techmoocher/kitsujikan/kitsujikan_BOM.csv

Reference | Qty | Part | KiCad footprint | Source | Link | Price (USD) | What It's For
U1 | 1 | Seeed Studio XIAO ESP32-C3 | Imported Parts:XIAO-ESP32-C6-DIP | Amazon | https://www.amazon.com/dp/B0DRNSV5CS | 10.99 | Main microcontroller
U1 (socket) | 2 | 1x7 female header, 2.54 mm | (part of U1 footprint) | DigiKey | https://www.digikey.com/en/products/detail/sullins-connector-solutions/PPTC071LFBN-RC/810146 | 1.16 | Socket for the ESP32-C3 module
J3 (module) | 1 | 0.96 in SSD1306 OLED, 128x64, I2C, 4-pin | Imported Parts:Display_128x64_096_I2C | Amazon | https://www.amazon.com/dp/B0FSRQG23K | 3.33 | Main display module
J3 (socket) | 1 | 1x4 female header, 2.54 mm | Imported Parts:Display_128x64_096_I2C | DigiKey | https://www.digikey.com/en/products/detail/sullins-connector-solutions/PPTC041LFBN-RC/810144 | 0.42 | Socket for the display module
SW2, SW3, SW4, SW5, SW6 | 1 | 12x12x7.3 mm tactile switch + round cap | Button_Switch_THT:SW_PUSH-12mm | Amazon | https://www.amazon.com/dp/B0H271MTGK | 3.99 | Buttons for choosing modes, YES, NO
SW1 | 1 | C&K OS102011MS2QN1 | Button_Switch_THT:SW_Slide_SPDT_Straight_CK_OS102011MS2Q | DigiKey | https://www.digikey.com/en/products/detail/c-k/OS102011MS2QN1/411602 | 0.8 | On/off switch
J1 | 1 | JST PH 2-pin, side entry (S2B-PH-K-S) | Connector_JST:JST_PH_S2B-PH-K_1x02_P2.00mm_Horizontal | DigiKey | https://www.digikey.com/en/products/detail/jst-sales-america-inc/S2B-PH-K-S/926626 | 0.12 | Battery connector
BAT | 1 | 3.7 V LiPo, 500-1000 mAh, protection circuit, JST-PH 2.0 plug | — | Amazon | https://www.amazon.com/dp/B0GHR5J34D?ref=ppx_yo2ov_dt_b_fed_asin_title | 7.49 | Main battery
BZ1 | 1 | Passive magnetic buzzer, 12 mm, 7.6 mm pin spacing, 3 V | Buzzer_Beeper:Buzzer_12x9.5RM7.6 | DigiKey | https://www.digikey.com/en/products/detail/same-sky-formerly-cui-devices/CEM-1203-42/412412 | 1.04 | Buzzer for sound output
Q1 | 1 | 2N3904 NPN transistor, TO-92 | Package_TO_SOT_THT:TO-92_Inline | DigiKey | https://www.digikey.com/en/products/detail/onsemi/2N3904BU/1413 | 0.29 | Transistor for driving the buzzer
R1, R2 | 2 | 200 kΩ, 1/4 W | Resistor_THT:R_Axial_DIN0207_L6.3mm_D2.5mm_P10.16mm_Horizontal | DigiKey | https://www.digikey.com/en/products/detail/stackpole-electronics-inc/CF14JT200K/1741338 | 0.027 | Pull-up resistors for I2C lines
R3, R5 | 2 | 10 kΩ, 1/4 W | Resistor_THT:R_Axial_DIN0207_L6.3mm_D2.5mm_P10.16mm_Horizontal | DigiKey | https://www.digikey.com/en/products/detail/stackpole-electronics-inc/CF14JT10K0/1741265 | 0.027 | Pull-down resistors for buttons
R4 | 1 | 1 kΩ, 1/4 W | Resistor_THT:R_Axial_DIN0207_L6.3mm_D2.5mm_P10.16mm_Horizontal | DigiKey | https://www.digikey.com/en/products/detail/stackpole-electronics-inc/CF14JT1K00/1741314 | 0.027 | Current-limiting resistor for the buzzer
C1 | 1 | 100 nF ceramic capacitor (104) | Capacitor_THT:C_Disc_D5.0mm_W2.5mm_P5.00mm | DigiKey | https://www.digikey.com/en/products/detail/onsemi/1N4148/458603 | 0.1 | Decoupling capacitor for the ESP32-C3
PCB | 5 | 2-layer PCB, 65 x 90 mm, 1.6 mm, HASL | — | JLCPCB | https://jlcpcb.com | 0.80 | Printed circuit board for the project
