techmoocher/kitsujikan/kitsujikan_schematic.pdf

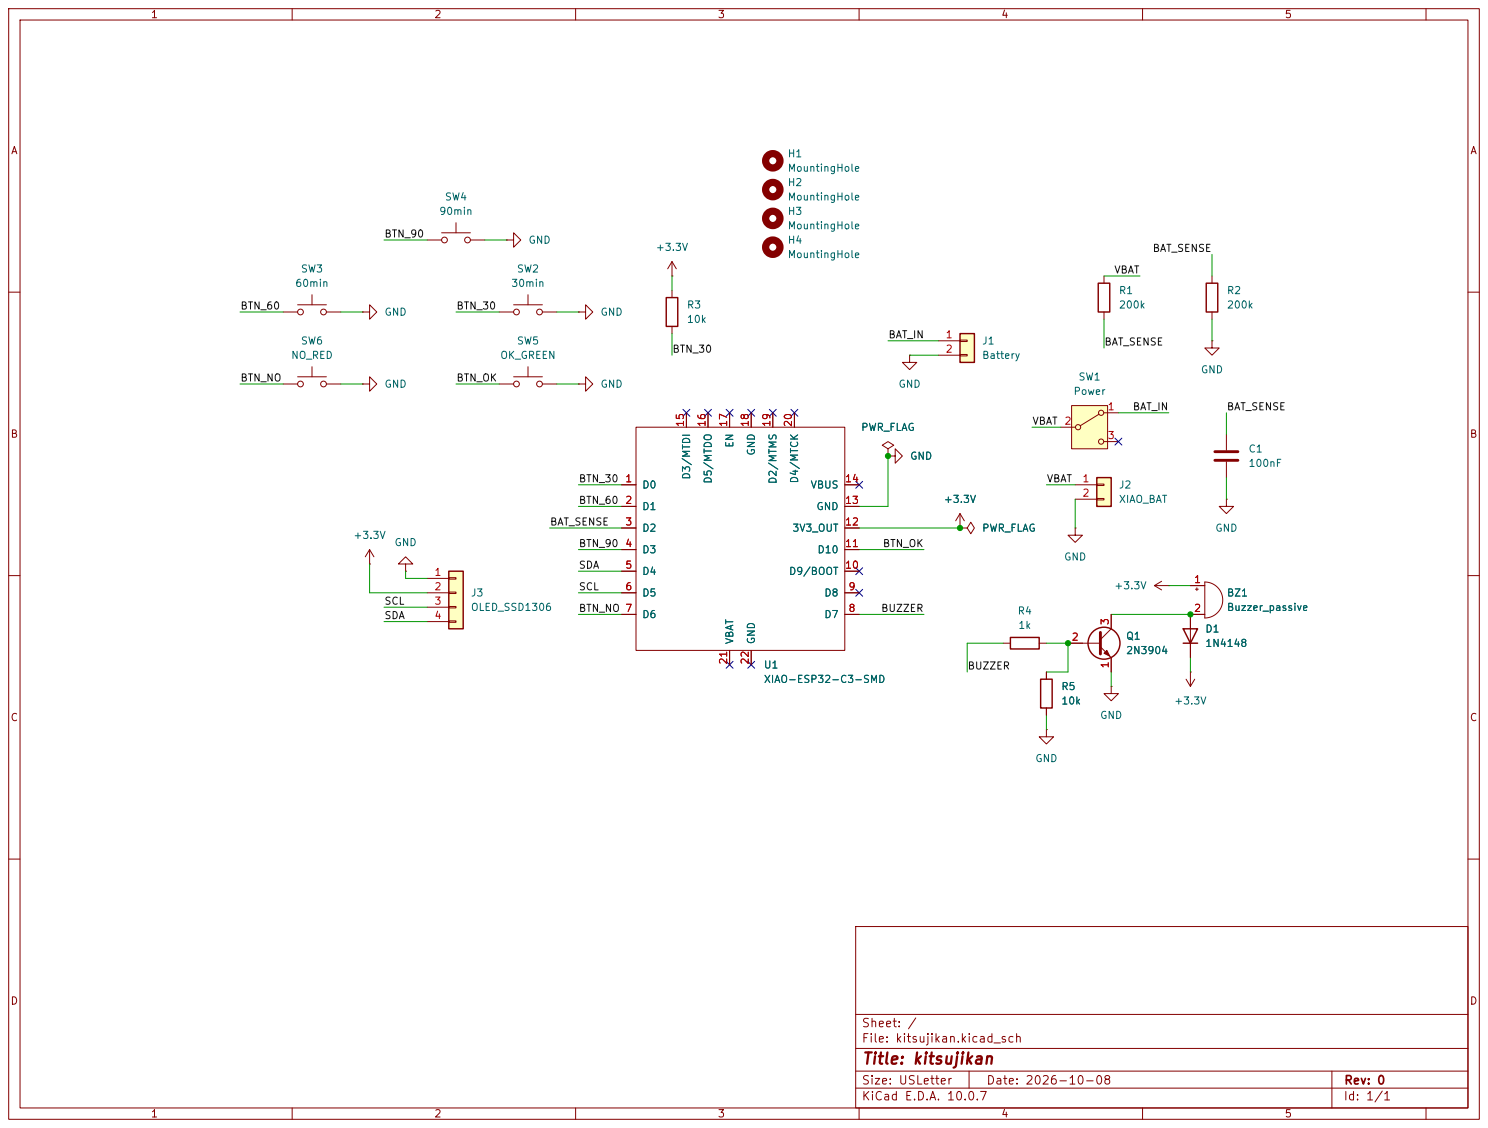
[picture p10: page 1]

Size: USLetter | Rev: 0
KiCad E.D.A. 10.0.7 | Id: 1/1
