techmoocher/kitsujikan/PCB/production/pdf/kitsujikan-B_Cu.pdf

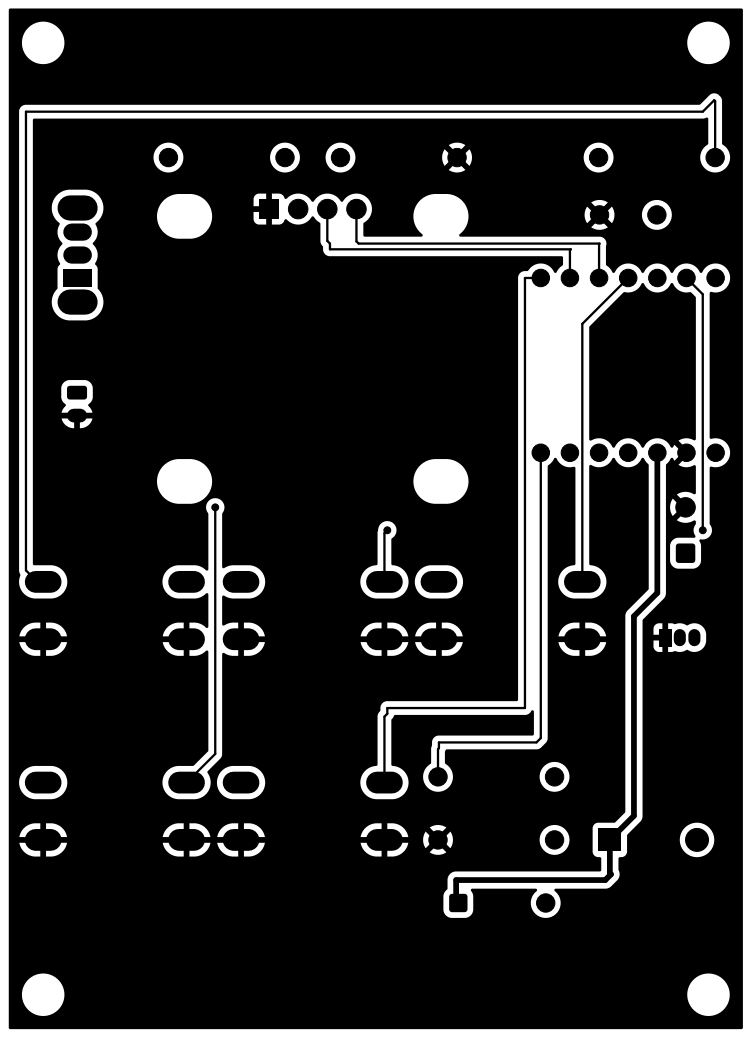
[picture p11: page 1]
