techmoocher/kitsujikan/PCB/production/pdf/kitsujikan-B_Mask.pdf

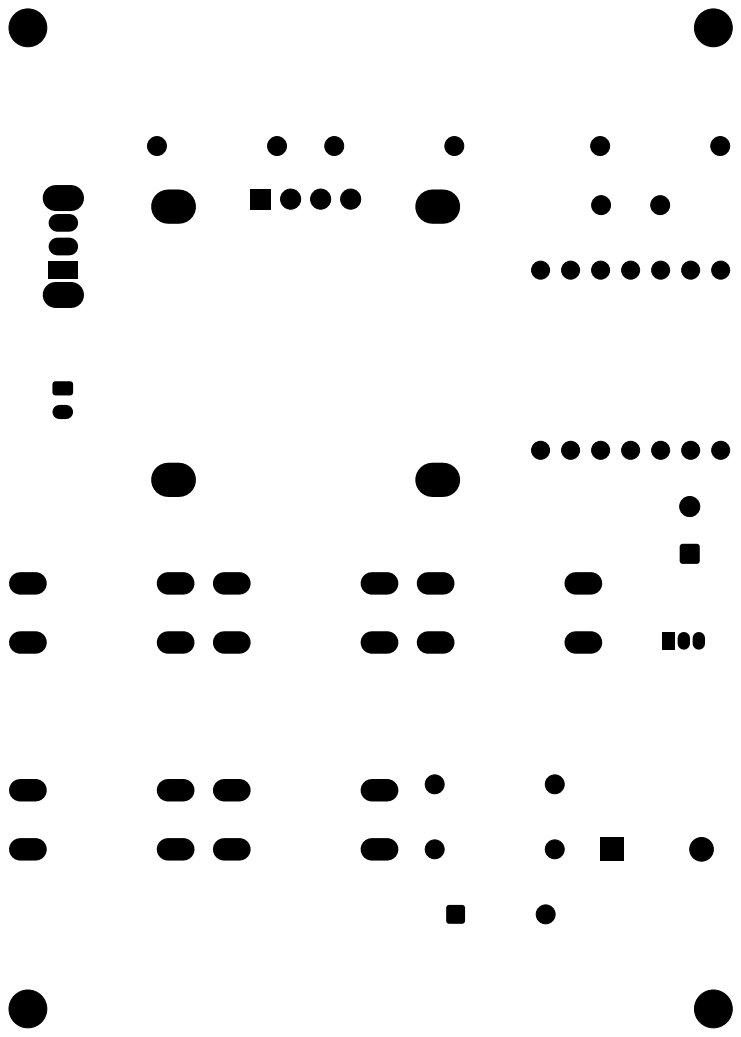
[picture p12: page 1]
