techmoocher/kitsujikan/PCB/production/pdf/kitsujikan-F_Cu.pdf

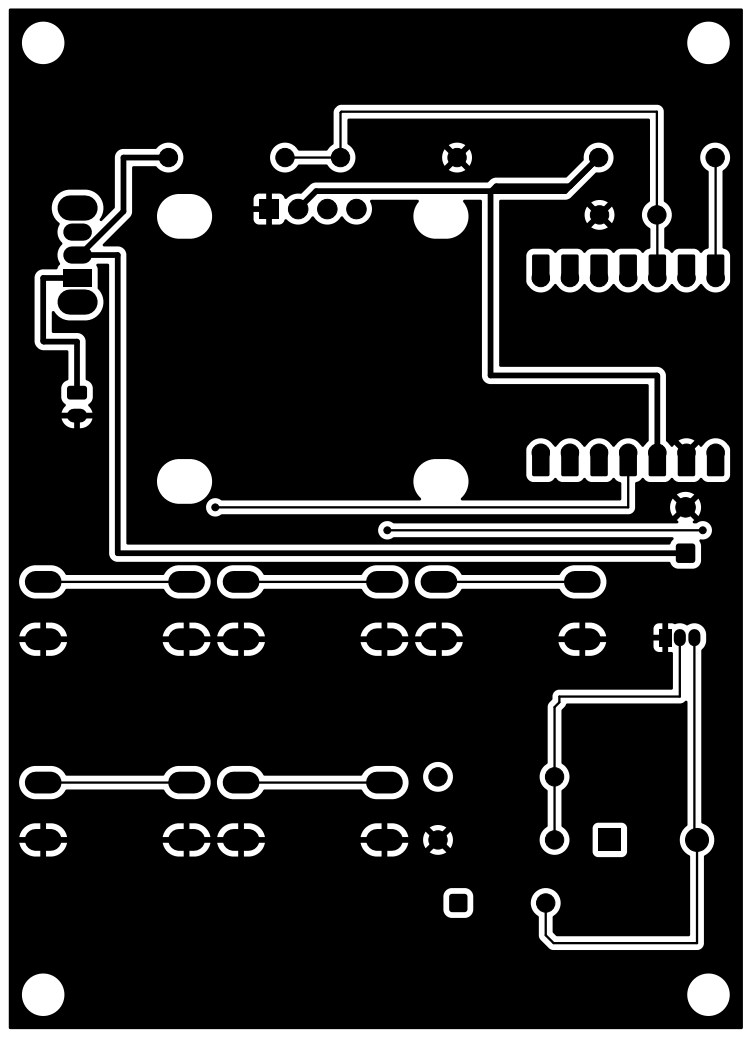
[picture p13: page 1]
