techmoocher/kitsujikan/PCB/production/pdf/kitsujikan-F_Mask.pdf

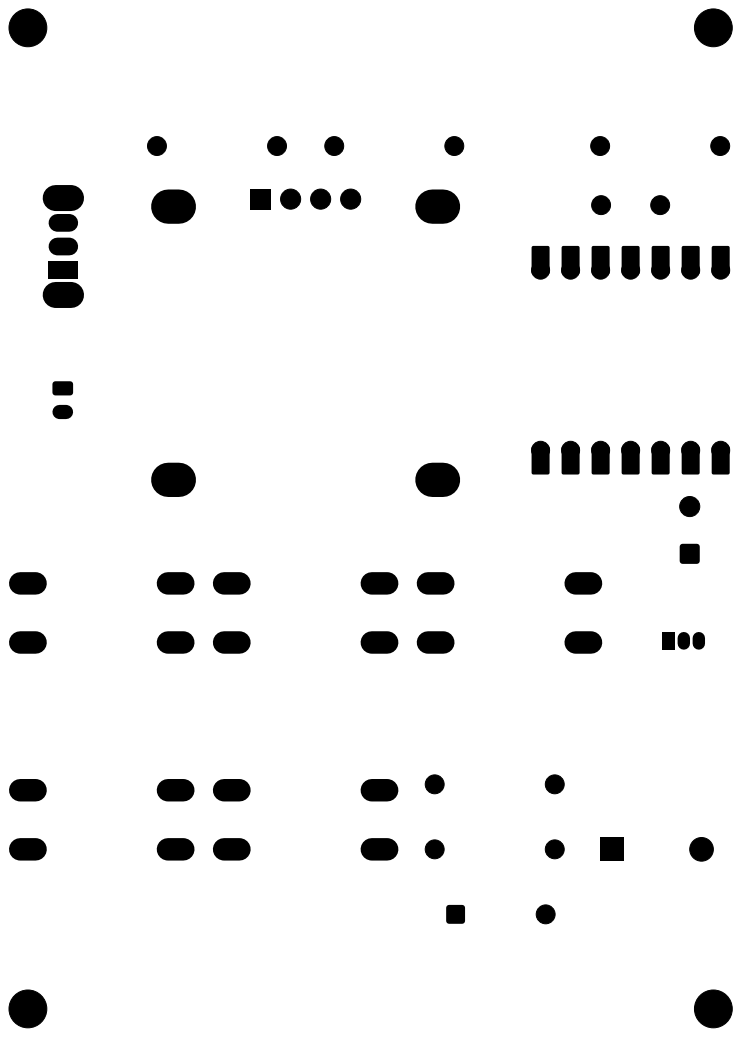
[picture p14: page 1]
