techmoocher/kitsujikan/PCB/production/pdf/kitsujikan-F_Silkscreen.pdf

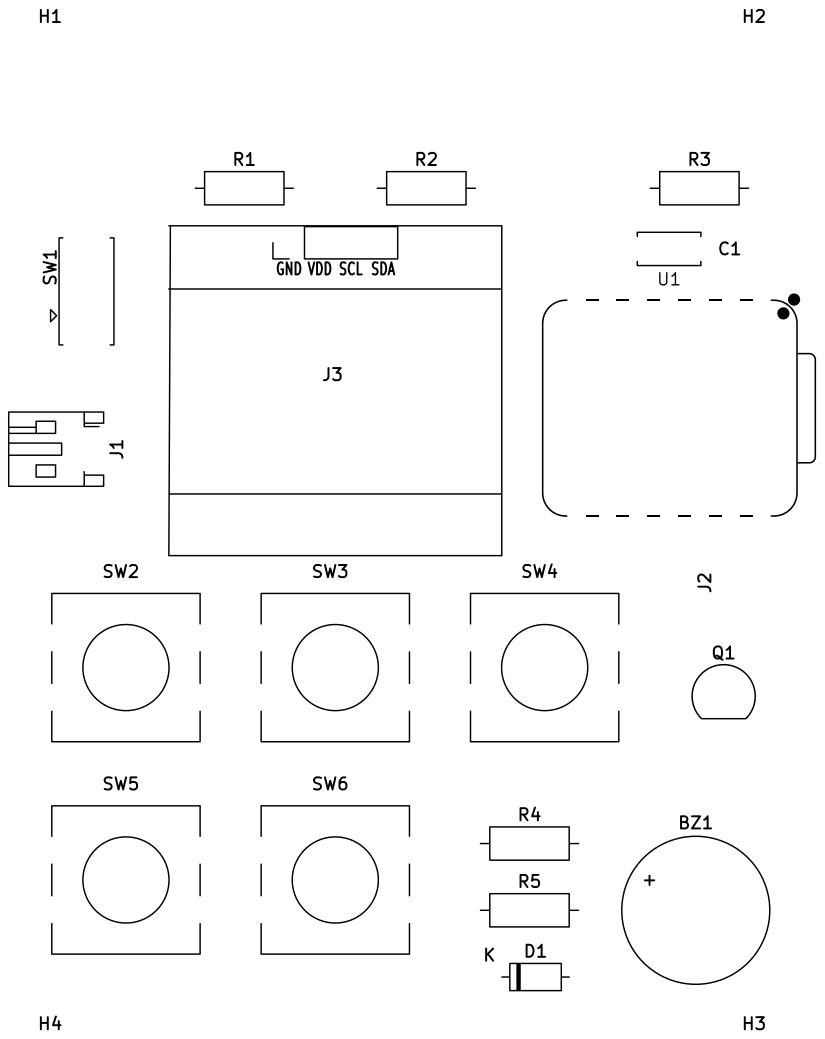
[picture p15: page 1]
