techmoocher/kitsujikan/PCB/kitsujikan.kicad_pcb

## KiCad design PCB/kitsujikan.kicad_pcb (2026-10-20)

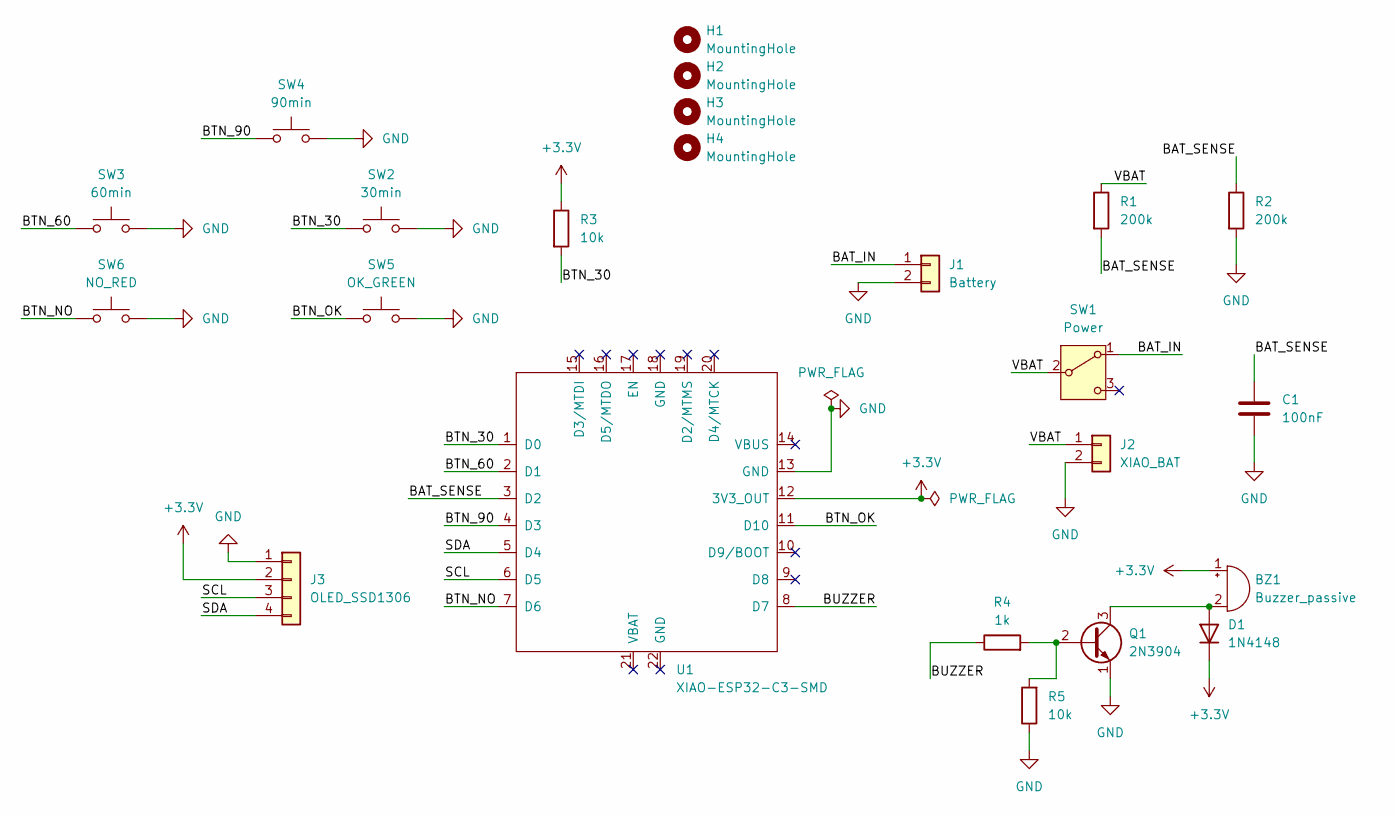
[picture p16: schematic kitsujikan.kicad_sch]

Parts:
BZ1: Buzzer_passive; Buzzer_12x9.5RM7.6
C1: 100nF; C_Disc_D5.0mm_W2.5mm_P5.00mm
D1: 1N4148; D_DO-35_SOD27_P7.62mm_Horizontal
H1, H2, H3, H4: MountingHole; MountingHole_3.2mm_M3
J1: Battery; JST_PH_S2B-PH-K_1x02_P2.00mm_Horizontal
J2: XIAO_BAT; SolderWire-0.15sqmm_1x02_P4mm_D0.5mm_OD1.5mm
J3: OLED_SSD1306; Display_128x64_096_I2C
Q1: 2N3904; TO-92_Inline
R1, R2: 200k; R_Axial_DIN0207_L6.3mm_D2.5mm_P10.16mm_Horizontal
R3, R5: 10k; R_Axial_DIN0207_L6.3mm_D2.5mm_P10.16mm_Horizontal
R4: 1k; R_Axial_DIN0207_L6.3mm_D2.5mm_P10.16mm_Horizontal
SW1: Power; SW_Slide_SPDT_Straight_CK_OS102011MS2Q
SW2: 30min; SW_PUSH-12mm
SW3: 60min; SW_PUSH-12mm
SW4: 90min; SW_PUSH-12mm
SW5: OK_GREEN; SW_PUSH-12mm
SW6: NO_RED; SW_PUSH-12mm
U1: XIAO-ESP32-C3-SMD; XIAO-ESP32-C6-DIP

Connections:
+3.3V: BZ1.1 (+), D1.1 (K), J3.2, R3.1, U1.12 (3V3_OUT)
/BAT_IN: J1.1, SW1.1 (A)
/BAT_SENSE: C1.1, R1.2, R2.1, U1.3 (D2)
/BTN_30: R3.2, SW2.1, U1.1 (D0)
/BTN_60: SW3.1, U1.2 (D1)
/BTN_90: SW4.1, U1.4 (D3)
/BTN_NO: SW6.1, U1.7 (D6)
/BTN_OK: SW5.1, U1.11 (D10)
/BUZZER: R4.1, U1.8 (D7)
/SCL: J3.3, U1.6 (D5)
/SDA: J3.4, U1.5 (D4)
/VBAT: J2.1, R1.1, SW1.2 (B)
GND: C1.2, J1.2, J2.2, J3.1, Q1.1 (E), R2.2, R5.1, SW2.2, SW3.2, SW4.2, SW5.2, SW6.2, U1.13 (GND)
unnamed: BZ1.2 (-), D1.2 (A), Q1.3 (C)
unnamed: Q1.2 (B), R4.2, R5.2

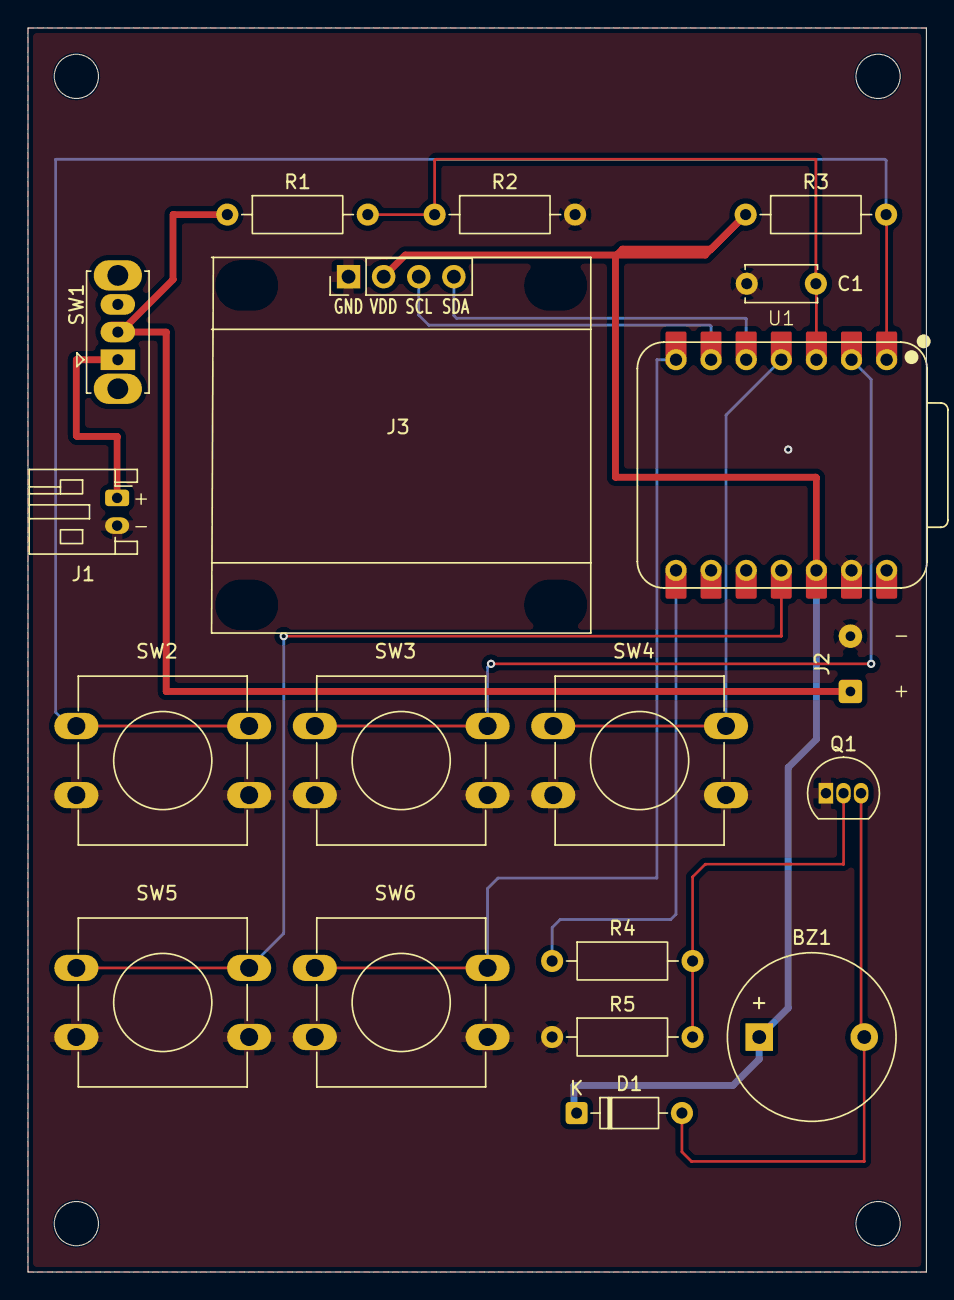
[picture p17: board kitsujikan.kicad_pcb from above]

Board: 2 copper layers, 65.0 x 90.0 mm, 23 parts (0 on the bottom side), 15 nets.
