techmoocher/kitsujikan/(commit log)

2026-10-09 Week 1: schematic, PCB, production files, BOM, README
2026-10-09 week 1: fix wiring route
2026-10-14 week 1: BAT+/BAT- silkscreen label
2026-10-14 week 1: silkscreen label update
2026-10-14 week 1: silkscreen labels
2026-10-29 BOM update
